pluggee/R1001/pcb/R1001.kicad_pcb

## KiCad design pcb/R1001.kicad_pcb (2017-04-16)

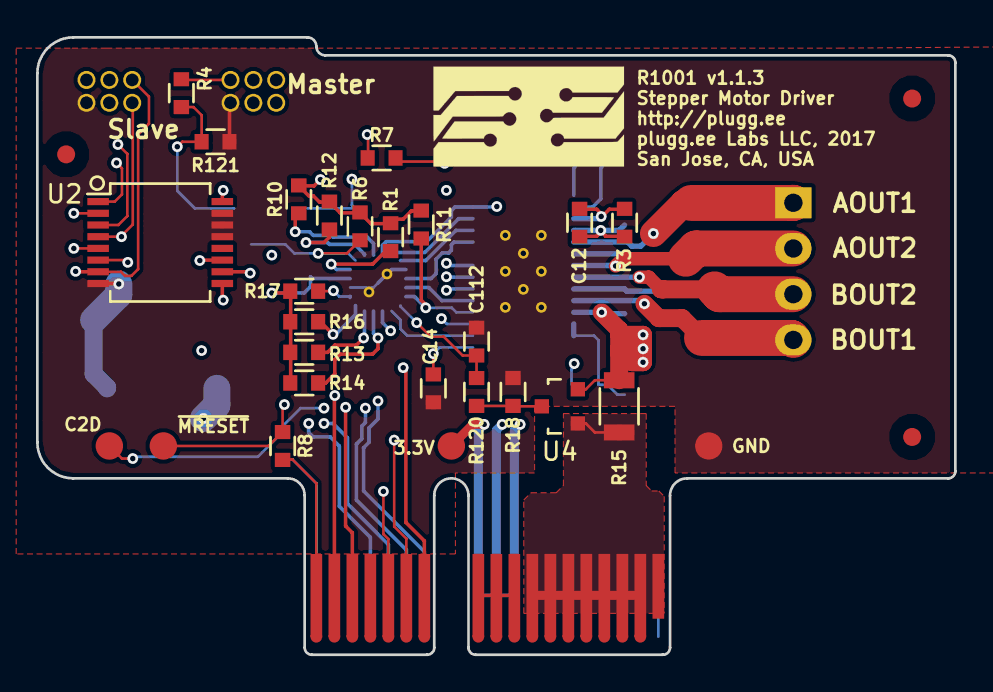
[picture p1: board R1001.kicad_pcb from above]

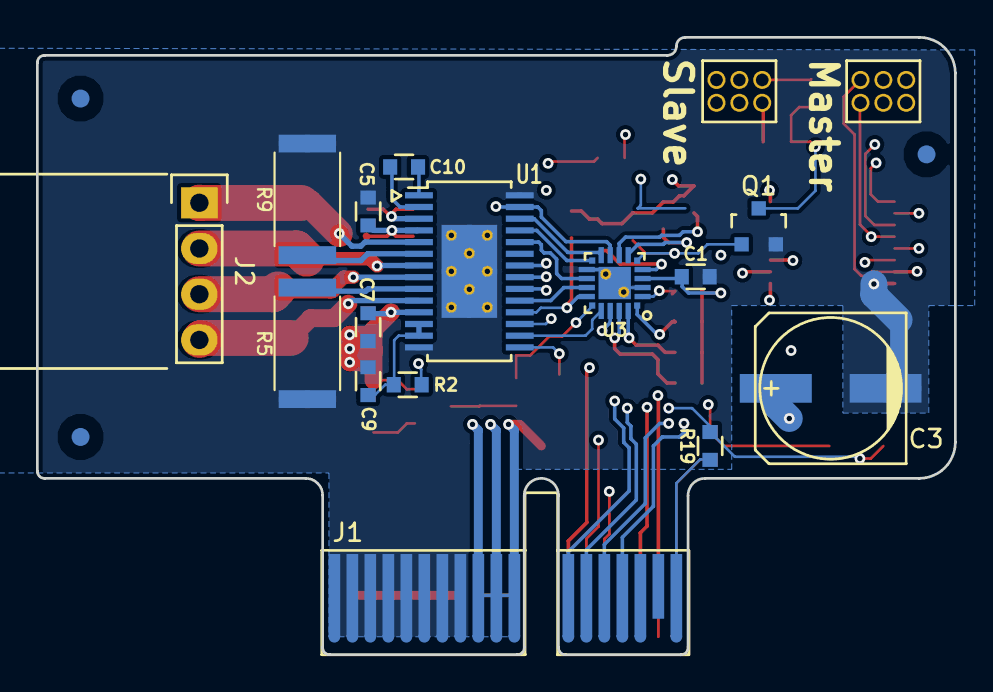
[picture p2: board R1001.kicad_pcb from below]

Board: 4 copper layers, 51.0 x 34.3 mm, 50 parts (20 on the bottom side), 47 nets.

Parts:
A1: ART; pluggeeLabsIcon-11x6
C1, C5, C7, C12: CC0603KRX7R9BB104; CAPC0603
C3: 47uF; c_elec_8x6.5
C9, C14, C112: CC0603KRX5R6BB105; CAPC0603
C10: CC0603KRX7R9BB103; CAPC0603
FID1, FID2, FID3, FID4, FID5, FID6: FIDTOP001
J1: PCIEXPRESS-X1
J2: CONN_01X04; 70553-0038
JMASTER1: SOCKMALE_02x03; SOCKET127P-02X03
JSLAVE1: SOCKMALE_02x03; SOCKET127P-02X03
Q1: Q_NMOS_GSD; SOT190P290X130X100-3
R1, R2, R6, R7, R10, R11, R12, R13, R14, R16, R17: RC0603FR-0710KL; RESC0603
R3: RC0603FR-071ML; RESC0603
R4, R18: RC0603FR-072K8L; RESC0603
R5, R9: RHC2512FTR250; RESC2512
R8, R19: RC0603FR-071KL; RESC0603
R15: ERJ-8CWFR050V; RESC1206
R120, R121: RC0603FR-07100KL; RESC0603
TP1, TP2, TP3, TP4: TestPoint; TestPoint000
U1: DRV8825; SOP65P970X440X120-28NT518X310
U2: 74LS157; SOP65P620X530X200-16
U3: EFM8BB10F8G; QFN50P300X300X75-20NT170X170
U4: ZXCT1107; SOT190P290X130X100-3

Connections:
+3V3: C1.1, J1.B9, J1.B10, J1.B11, JMASTER1.6, R1.1, R6.1, R7.1, R10.1, R11.1, R12.1, R13.1, R14.1, R16.1, R17.1, TP1.1, U1.17, U2.16, U3.4
+5V: J1.A9, J1.A10, J1.A11
/C2D_CON: J1.B18, R19.1
/D1_AOUT1: J2.1, U1.5
/D1_AOUT2: J2.2, U1.7
/D1_BOUT1: J2.4, U1.10
/D1_BOUT2: J2.3, U1.8
/D1_CP1: C10.2, U1.1
/D1_CP2: C10.1, U1.2
/D1_ISENA: R9.1, U1.6
/D1_ISENB: R5.1, U1.9
/D1_V3P3: C14.1, U1.15
/D1_VCP: C12.2, R3.2, U1.3
/DIR: JMASTER1.3, U1.20, U2.9
/D_VREF: C9.1, R2.1, U1.12, U1.13
/HT_CON: J1.A1, J1.A2, J1.A3, J1.A4, J1.A5, J1.A6, J1.A7, J1.A8, R15.1, U4.1
/IVDD_SENSE: C112.1, R120.2, U3.16
/MCU_DECAY: U1.19, U3.14
/MCU_MODE0: U1.24, U3.13
/MCU_MODE1: U1.25, U3.11
/MCU_MODE2: U1.26, U3.10
/MCU_PWMVREF: R2.2, U3.18
/SLAVE_ENABLE: Q1.3, R4.2, R121.1, U2.1
/SLAVE_ENABLE_CON: JSLAVE1.6, R4.1
/STEP: JMASTER1.1, U1.22, U2.4
/S_DIR: JSLAVE1.3, U2.10
/S_STEP: JSLAVE1.1, U2.3
/S_~ENBL: JSLAVE1.2, U2.6
/~D1_FAULT: R11.2, U1.18, U3.15
/~D1_HOME: R7.2, U1.27, U3.9
/~ENBL: JMASTER1.2, U1.21, U2.7
/~MCU_DRESET: U1.16, U3.17
/~MRESET_CON: J1.A18, R8.2
C2D: Q1.1, R6.2, R19.2, TP4.1, U3.6
GND: C1.2, C3.2, C5.2, C7.2, C9.2, C14.2, C112.2, J1.B1, J1.B2, J1.B3, J1.B4, J1.B5, J1.B6, J1.B7, J1.B8, JMASTER1.5, JSLAVE1.5, Q1.2, R5.2, R9.2, R18.2, R121.2, TP2.1, U1.14, U1.28, U1.29, U2.8, U2.13, U2.14, U2.15, U3.3, U3.12, U3.21
HT: C3.1, C5.1, C7.1, C12.1, R3.1, R15.2, U1.4, U1.11, U4.2
ID0: J1.B12, R14.2, U3.19
ID1: J1.B13, R13.2, U3.20
ID2: J1.B14, R12.2, U3.7
ID3: J1.B15, R10.2, U3.8
unnamed: R18.1, R120.1, U4.3
PX1_DIR: J1.A12, U2.11
PX2_~ENBL: J1.A13, U2.5
PX3_STEP: J1.A14, U2.2
SCL: J1.A16, R17.2, U3.2
SDA: J1.A17, R16.2, U3.1
~MRESET: R1.2, R8.1, TP3.1, U3.5
