pluggee/R1001/(threads)

Thread 2 (2017-02-26):

Update R1001 application firmware

pluggee, 2017-02-26:
- add the capability to read the HT voltage and current
- add monitoring of 3.3V supply through the internal ADC, then compensate the PWM value to improve precision of stepper motor current

Thread 3 (2017-03-26):

v1.1 features

pluggee, 2017-03-26:
BOM fixes:
- Change R3 to 10k, 1MEG is too high and forms a resistor divider with the MCU input
- update R/C elements with new symbols

PCB Changes
- verify pin 1 orientation silkscreen
