pluggee/R1001/(commit log)

2016-07-02 moved design to repo
    [R1001.kicad_pcb, R1001.sch]
2016-07-02 updated design, placed driver
    [R1001.kicad_pcb, R1001.sch]
2016-07-03 completed layout
    [R1001.kicad_pcb, R1001.sch]
2016-07-03 created solder mask opening for large heat sink on bottom layer
    [R1001.kicad_pcb]
2016-07-03 optimized layout for thermal
    [R1001.kicad_pcb]
2016-07-23 v1.0.0-beta complete
    [R1001-B.Cu.gbr, R1001-B.Mask.gbr, R1001-B.Paste.gbr, R1001-B.SilkS.gbr, R1001-Edge.Cuts.gbr, R1001-F.Cu.gbr, R1001-F.Mask.gbr, R1001-F.Paste.gbr]
2016-07-23 added silk screen to motor pins
    [R1001-B.Cu.gbr, R1001-B.Mask.gbr, R1001-B.Paste.gbr, R1001-B.SilkS.gbr, R1001-Edge.Cuts.gbr, R1001-F.Cu.gbr, R1001-F.Mask.gbr, R1001-F.Paste.gbr]
2016-08-19 added BOM
    [R1001_BOM.csv]
2016-09-07 released 1.02 beta to adjust assign busy bee I2C pins to 0.0 and 0.1
    [R1001-B.Cu.gbr, R1001-B.Mask.gbr, R1001-B.Paste.gbr, R1001-B.SilkS.gbr, R1001-Edge.Cuts.gbr, R1001-F.Cu.gbr, R1001-F.Mask.gbr, R1001-F.Paste.gbr]
2016-09-11 added 1st cut firmware
2016-10-23 fixed driver current function, added .gitignore
    [R1001_fw_main.c, drv8825.c, drv8825.h, global.h, i2c.c]
2016-10-26 fixed 2000mA limiting of IDRVH and IDRVL registers
    [drv8825.c]
2016-12-06 layout wip
    [R1001.kicad_pcb]
2016-12-09 ready for v1.0.3 release
    [R1001-B.Cu.gbr, R1001-B.Mask.gbr, R1001-B.Paste.gbr, R1001-B.SilkS.gbr, R1001-Edge.Cuts.gbr, R1001-F.Cu.gbr, R1001-F.Mask.gbr, R1001-F.Paste.gbr]
2016-12-22 updated BOM file
    [R1001_BOM.csv]
2017-01-11 updated BOM
    [R1001_BOM.csv]
2017-02-14 added MCU mem map and initial bootloader code
    [EFM8BB10_mem_map.xlsx]
2017-02-15 got bootloader I2C to function, not tested yet with an application image, wip
2017-02-16 updated for silabs support case
2017-02-21 updated BL, flash functions work, still startup function doesnt work and cant get device out of bootloader, stuck in flash reset
    [BL_functions.c, R1001_bl_main.c, R1001_bl_main.h, smb.c]
2017-03-28 added silk screen, fixed SOP footprint for pin 1 silkscreen, fixed 50mil connector drill size
    [R1001.kicad_pcb, R1001.sch]
2017-03-28 exported gerbers, added legend
    [R1001-B.Cu.gbr, R1001-B.Mask.gbr, R1001-B.Paste.gbr, R1001-B.SilkS.gbr, R1001-Edge.Cuts.gbr, R1001-F.Cu.gbr, R1001-F.Mask.gbr, R1001-F.Paste.gbr]
2017-03-28 recreated gerbers, cleaned up BOM
    [R1001-B.Cu.gbr, R1001-B.Mask.gbr, R1001-B.Paste.gbr, R1001-B.SilkS.gbr, R1001-Edge.Cuts.gbr, R1001-F.Cu.gbr, R1001-F.Mask.gbr, R1001-F.Paste.gbr]
2017-03-28 fixed silk screen version to v1.1
    [R1001-B.Cu.gbr, R1001-B.Mask.gbr, R1001-B.Paste.gbr, R1001-B.SilkS.gbr, R1001-Edge.Cuts.gbr, R1001-F.Cu.gbr, R1001-F.Mask.gbr, R1001-F.Paste.gbr]
2017-03-28 added ms excel export
    [R1001_BOM.xlsx]
2017-03-29 added SMT assembly files
2017-03-29 added extra FID, changed silkscreen version to 1.1.1
    [R1001-B.Cu.gbr, R1001-B.Mask.gbr, R1001-B.Paste.gbr, R1001-B.SilkS.gbr, R1001-Edge.Cuts.gbr, R1001-F.Cu.gbr, R1001-F.Mask.gbr, R1001-F.Paste.gbr]
2017-03-31 fixed BOM, marked RC parts GENERIC
    [R1001.sch, R1001_BOM.csv, R1001_BOM.ods, R1001_BOM.xlsx]
2017-04-12 fixed silk screen signal names
    [R1001-B.Cu.gbr, R1001-B.Mask.gbr, R1001-B.Paste.gbr, R1001-B.SilkS.gbr, R1001-Edge.Cuts.gbr, R1001-F.Cu.gbr, R1001-F.Mask.gbr, R1001-F.Paste.gbr]
2017-04-14 read for version 1.1.2, crowdsupply build
    [R1001-B.Cu.gbr, R1001-B.Mask.gbr, R1001-B.Paste.gbr, R1001-B.SilkS.gbr, R1001-Edge.Cuts.gbr, R1001-F.Cu.gbr, R1001-F.Mask.gbr, R1001-F.Paste.gbr]
2017-04-16 fixed PCB outline for DFM, more space for bonding connectors
    [R1001-B.Cu.gbr, R1001-B.Mask.gbr, R1001-B.Paste.gbr, R1001-B.SilkS.gbr, R1001-Edge.Cuts.gbr, R1001-F.Cu.gbr, R1001-F.Mask.gbr, R1001-F.Paste.gbr]
